brentmaxwell/Arduino-EEG-Experiments/Schematic/EEG schematic.png

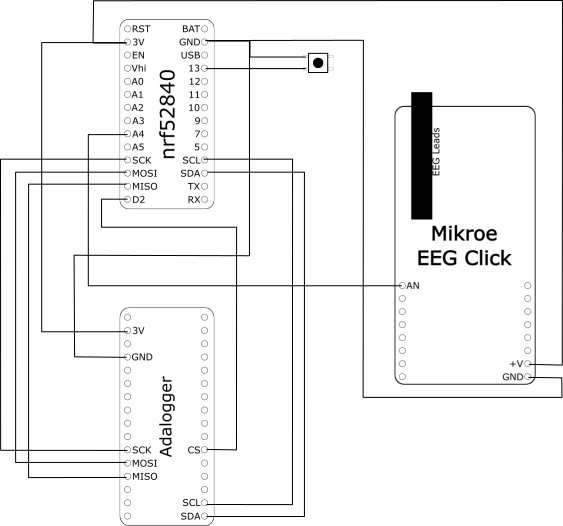
Schematic/EEG schematic.png
