brentmaxwell/Arduino-EEG-Experiments/BluetoothEEG/Hardware.h

#define LED_PIN PIN_LED1
#define NEOPIXEL_PIN PIN_NEOPIXEL
#define EEG_PIN PIN_A0
#define BATTERY_PIN PIN_VBAT
#define BUTTON_PIN 13
#define SD_CS 10

#define NUM_OF_NEOPIXELS NEOPIXEL_NUM

#define EEG_INPUT_REF 2.048
#define ADC_VOLTAGE_REF 3.6
#define ADC_RESOLUTION 14
