brentmaxwell/Arduino-EEG-Experiments/(commit log)

2022-12-22 added code to use Adafruit Fuel Gauge for the battery
2022-12-22 - Added BLE HRM Service - Renamed LED to StatusLED - Delete File command - lots of tiny changes due to some refactoring and experiments
